hamzaMahdi/smart-wheelchair/capstone_rosws/src/drive_wheelchair/src/drive.py

#!/usr/bin/env python
import rospy
import RPi.GPIO as IO
import time                            #calling time to provide delays in program
from std_msgs.msg import Float32MultiArray
from std_msgs.msg import Bool
IO.setwarnings(False)           #do not show any warnings

IO.setmode (IO.BOARD)
IO.setup(35,IO.OUT)           
IO.setup(32,IO.OUT)
p = IO.PWM(35,500)          
q = IO.PWM(32,500)
p.start(75)                              
q.start(75)
stop  = False
def callback(data):
    #global stop
    if(stop ==True):
        p.ChangeDutyCycle(65)
        q.ChangeDutyCycle(65)
	time.sleep(1)
        print "stopping the motors"
    else:
        rospy.loginfo(rospy.get_caller_id() + "I heard %s", data.data)
        p.ChangeDutyCycle(data.data[0])
        q.ChangeDutyCycle(data.data[1])
def danger_callback(flag):
    global stop
    #rospy.loginfo(rospy.get_caller_id() + "Stop is  %s", flag)
    if(flag.data==True):
        stop = False
    else:
        stop  = True
        #p.ChangeDutyCycle(75)
        #q.ChangeDutyCycle(75)
    #print(stop)

def listener():

    rospy.init_node('drive', anonymous=True)

    rospy.Subscriber("motors", Float32MultiArray, callback)
    rospy.Subscriber("/danger_flag", Bool, danger_callback)
    # spin() simply keeps python from exiting until this node is stopped
    rospy.spin()

if __name__ == '__main__':
    listener()
