hamzaMahdi/smart-wheelchair/(commit log)

2019-01-10 initial imu code commit
    TODO: fix gyro
    [main.cpp]
2019-01-10 ros code including lidar point cloud
2019-01-10 PWM code test to move brushed DC motors
2019-01-31 test new esc motor controllers
2019-02-01 new pwm code for the victors
2019-02-01 combined bluetooth and motor
2019-02-01 fixed tabs and spaces inconsistency
    [receive_IMU.py]
2019-02-01 Adding the arduino Code
2019-02-11 lidar stopping code
2019-02-11 fixed global stop bool
    [drive.py]
2019-02-11 fixed a bool problem
    [drive.py]
2019-02-11 script to publish fake data in case i dont have imu
2019-02-12 Adding my own package for IMU visualization
2019-03-08 updated arduino code
2019-03-18 Add files via upload
    ULTRASONIC PY CODE
2019-03-18 Add files via upload
    the final version of ultrasonic
2019-03-21 added ultrasonic code for wheelchair
2019-04-10 Adding the IMU RTIMULIB Arduino Library
2019-04-28 Delete ultrasonic.py
    clean repo
2019-04-28 added PCB gerber file
